lizard-electronics/Soldering_Fume_Extractor/1_Hardware/PCB/PCB_3DBack.png

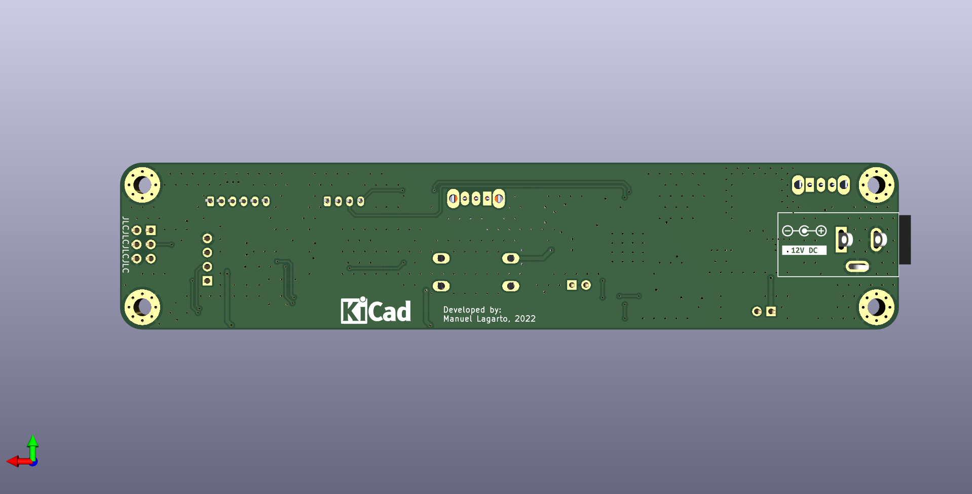
1_Hardware/PCB/PCB_3DBack.png
