lizard-electronics/Soldering_Fume_Extractor/README.md

# Soldering Fume Extractor
## [In Development...]
Portable soldering fume extractor based on an ATmega328P MCU.
