lizard-electronics/Soldering_Fume_Extractor/4_Docs/Dust Sensor Tests/dustSensor_test2.png

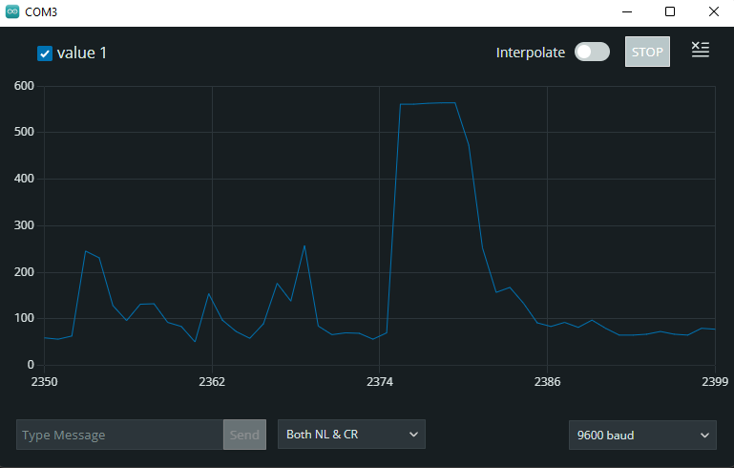
4_Docs/Dust Sensor Tests/dustSensor_test2.png
