lizard-electronics/Soldering_Fume_Extractor/4_Docs/Dust Sensor Tests/dustSensor_test.png

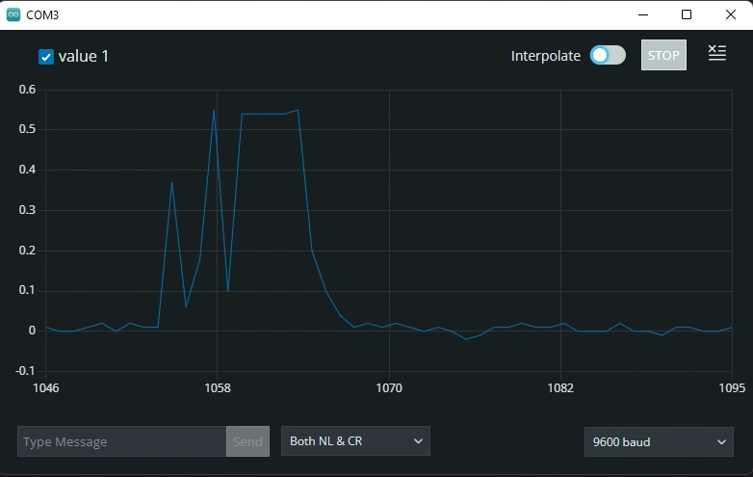
4_Docs/Dust Sensor Tests/dustSensor_test.png
