lizard-electronics/Soldering_Fume_Extractor/4_Docs/Dust Sensor Tests/SharpGP2Y1010AU0F_Graph.png

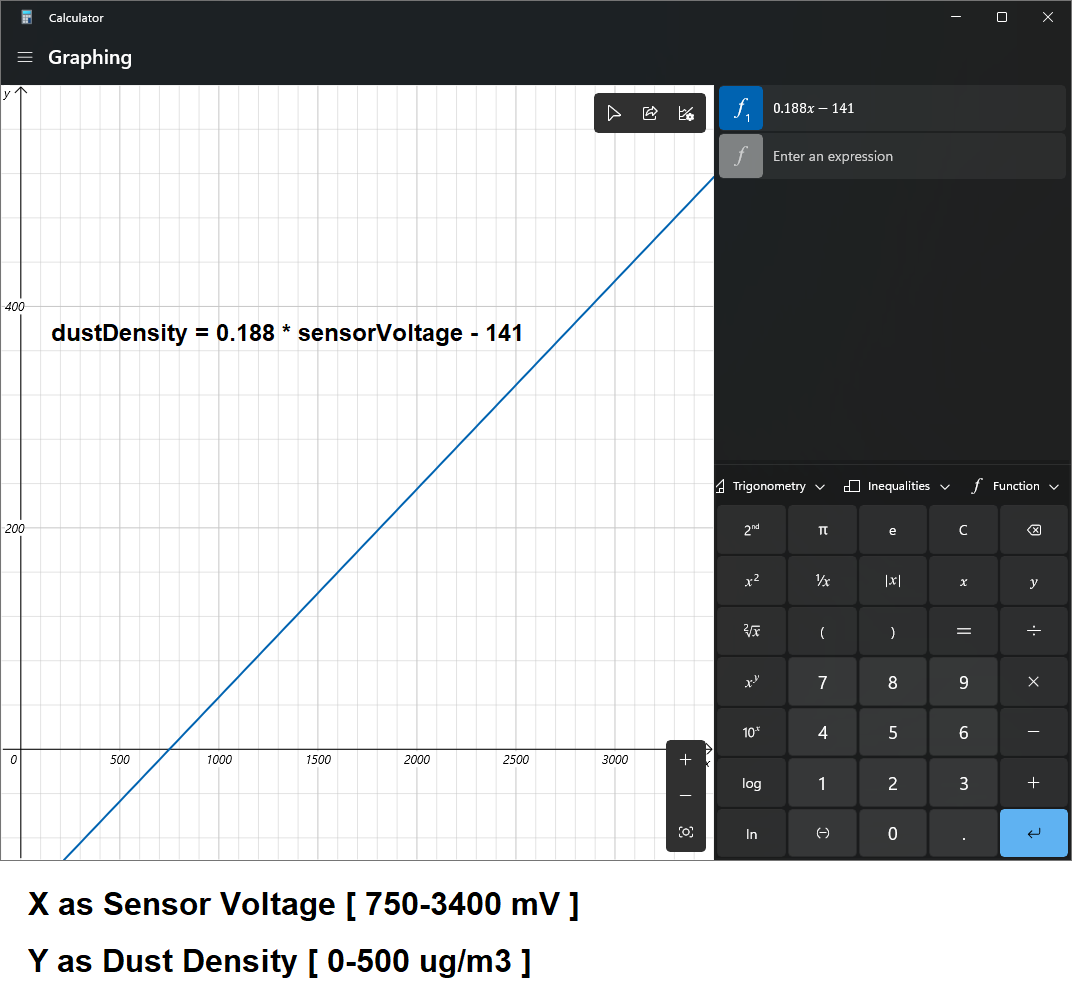
4_Docs/Dust Sensor Tests/SharpGP2Y1010AU0F_Graph.png
