lizard-electronics/Soldering_Fume_Extractor/4_Docs/FumeExtractor_Diagrams.pdf

# Power Supply Circuit Diagram

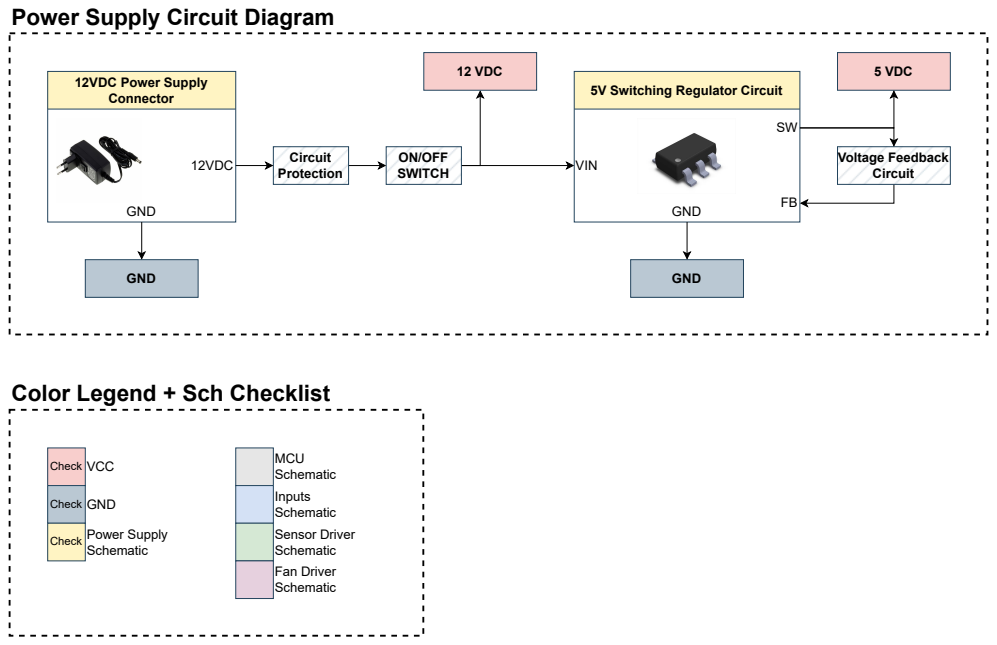
[picture p7: page 1]
Check VCC; Check GND; MCU Schematic; Inputs Schematic; Sensor Driver Schematic; Fan Driver Schematic; 12VDC Power Supply Connector; 12VDC; GND; VIN; 5 VDC; ON/OFF SWITCH; Circuit Protection; 12 VDC; Voltage Feedback Circuit

5V Switching Regulator Circuit

Color Legend + Sch Checklist

Check Power Supply
Schematic

# Fan Control Circuit Diagram

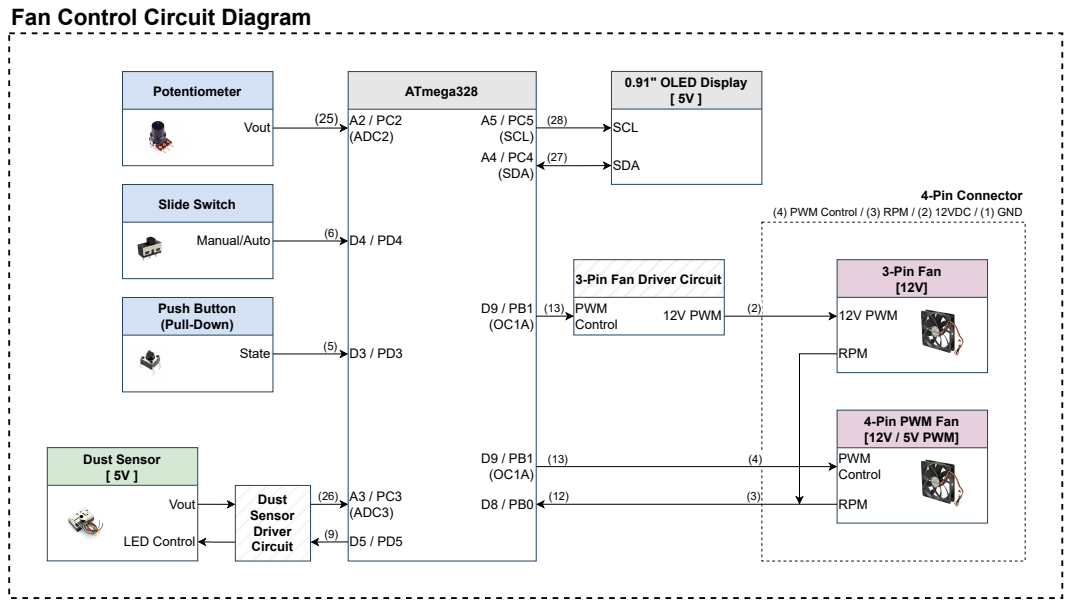
[picture p8: page 2]
ATmega328; A4 / PC4 (SDA); A5 / PC5 (SCL); A2 / PC2 (ADC2); A3 / PC3 (ADC3); 0.91" OLED Display [ 5V ]; SDA; SCL; Slide Switch; Manual/Auto; RPM; Dust Sensor [ 5V ]; Vout; LED Control; 3-Pin Fan [12V]; 12V PWM; PWM; Control; 12V PWM ⁽¹³⁾; 4-Pin Connector; Push Button (Pull-Down); State; Dust Sensor Driver Circuit; Potentiometer

(4) PWM Control / (3) RPM / (2) 12VDC / (1) GND

3-Pin Fan Driver Circuit

4-Pin PWM Fan
[12V / 5V PWM]
PWM
Control
