lizard-electronics/Soldering_Fume_Extractor/(list of files, drawings)

Other design files:
1_Hardware/PSPICE_Simulations/FumeExtractor_FanDriverTest.ms14
1_Hardware/PSPICE_Simulations/FumeExtractor_InputsTest.ms14
