lizard-electronics/Soldering_Fume_Extractor/1_Hardware/PCB/FumeExtractorBoard_v1/FumeExtractorBoard_v1.kicad_pcb

## KiCad design 1_Hardware/PCB/FumeExtractorBoard_v1/FumeExtractorBoard_v1.kicad_pcb (2022-10-18)

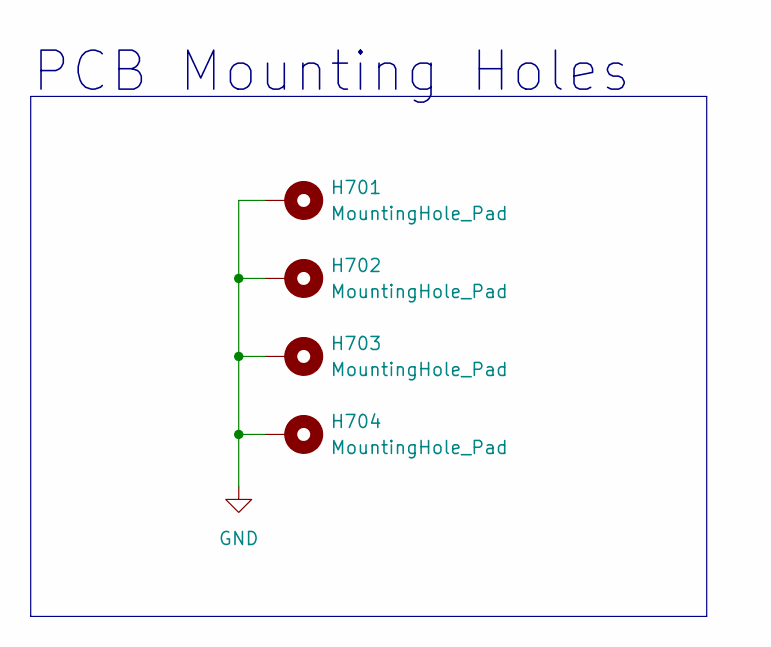
[picture p16: schematic MechanicalParts.kicad_sch, Mechanical Parts Schematic]

Parts:
H701, H702, H703, H704: MountingHole_Pad; MountingHole_3.2mm_M3_Pad_Via

Connections:
GND: H701.1, H702.1, H703.1, H704.1; also elsewhere on the board

Notes on the sheet:
PCB Mounting Holes

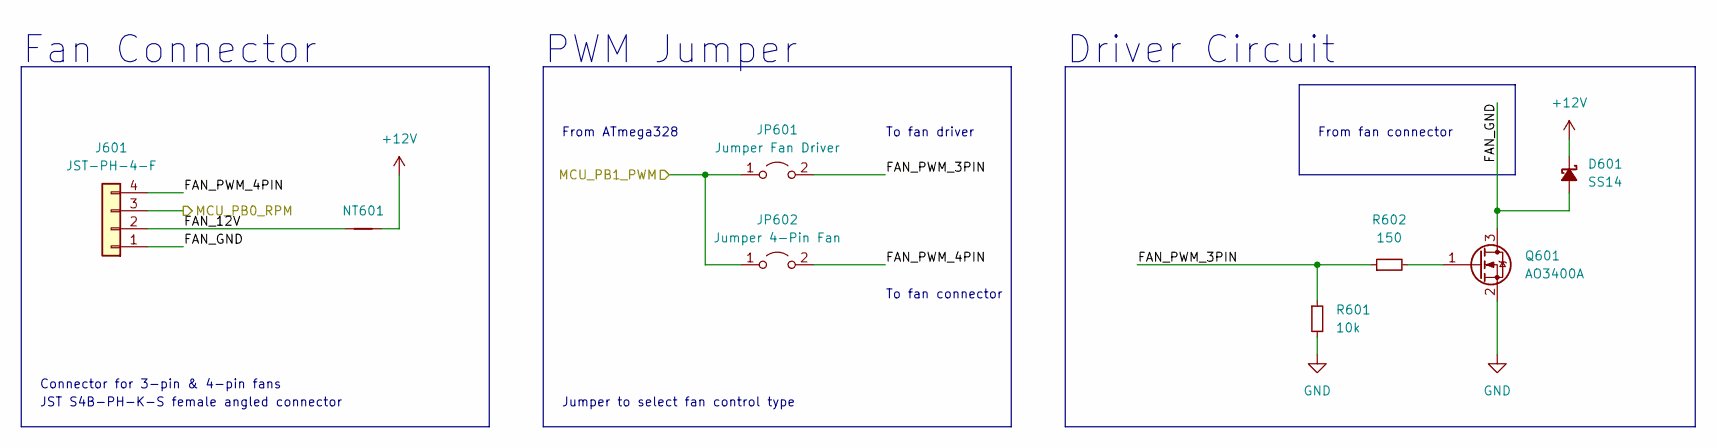
[picture p17: schematic FanDriver.kicad_sch, Fan Driver Circuit]

Parts:
D601: SS14; D_SMA
J601: JST-PH-4-F; JST_PH_S4B-PH-K_1x04_P2.00mm_Horizontal
JP601: Jumper Fan Driver; SolderJumper-2_P1.3mm_Open_RoundedPad1.0x1.5mm
JP602: Jumper 4-Pin Fan; SolderJumper-2_P1.3mm_Open_RoundedPad1.0x1.5mm
NT601: NetTie_2; NetTie-2_SMD_Pad0.5mm
Q601: AO3400A; SOT-23
R601: 10k; R_0603_1608Metric_Pad0.98x0.95mm_HandSolder
R602: 150; R_0805_2012Metric_Pad1.20x1.40mm_HandSolder

Connections:
+12V: D601.1 (K), NT601.2; also elsewhere on the board
/FanDriver/FAN_12V: J601.2, NT601.1
/FanDriver/FAN_GND: D601.2 (A), J601.1, Q601.3 (D)
/FanDriver/FAN_PWM_3PIN: JP601.2 (B), R601.1, R602.1
/FanDriver/FAN_PWM_4PIN: J601.4, JP602.2 (B)
/FanDriver/MCU_PB0_RPM: J601.3; also elsewhere on the board
/FanDriver/MCU_PB1_PWM: JP601.1 (A), JP602.1 (A); also elsewhere on the board
GND: Q601.2 (S), R601.2; also elsewhere on the board
unnamed: Q601.1 (G), R602.2

Notes on the sheet:
To fan connector
To fan driver
From fan connector
JST S4B-PH-K-S female angled connector
Fan Connector
PWM Jumper
Driver Circuit
Connector for 3-pin & 4-pin fans
From ATmega328
Jumper to select fan control type

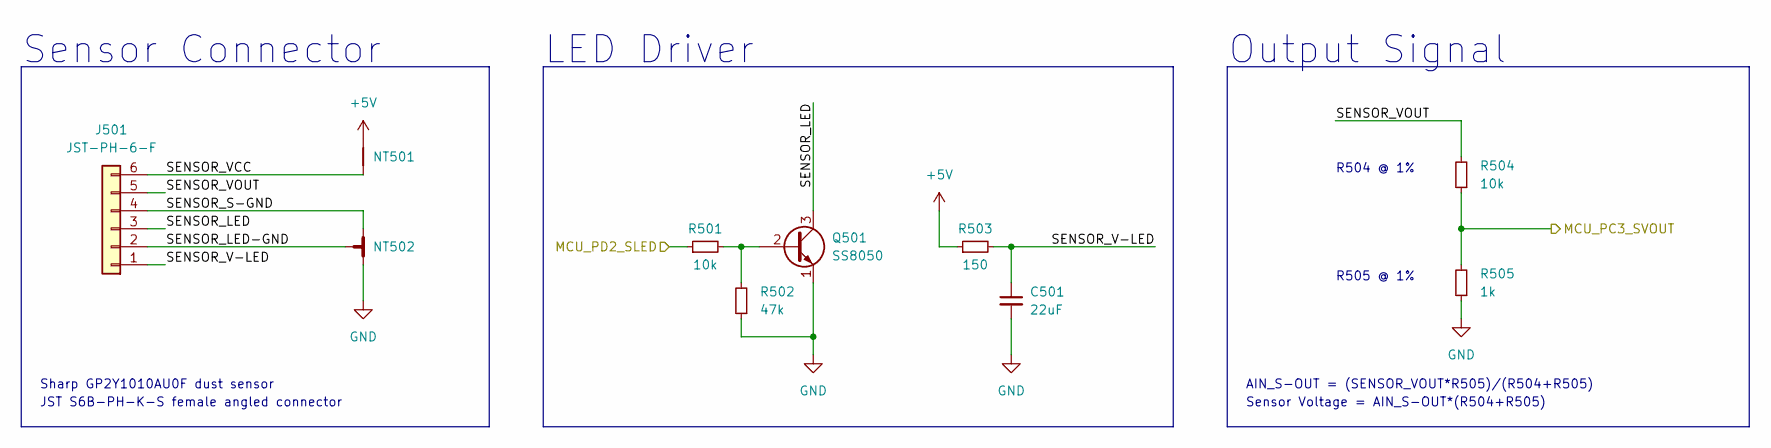
[picture p18: schematic SensorDriver.kicad_sch, Dust Sensor Driver Circuit]

Parts:
C501: 22uF; C_0805_2012Metric_Pad1.18x1.45mm_HandSolder
J501: JST-PH-6-F; JST_PH_S6B-PH-K_1x06_P2.00mm_Horizontal
NT501: NetTie_2; NetTie-2_SMD_Pad0.5mm
NT502: NetTie_3_Tee; NetTie-3_SMD_Pad0.5mm
Q501: SS8050; SOT-23
R501, R504: 10k; R_0603_1608Metric_Pad0.98x0.95mm_HandSolder
R502: 47k; R_0603_1608Metric_Pad0.98x0.95mm_HandSolder
R503: 150; R_0805_2012Metric_Pad1.20x1.40mm_HandSolder
R505: 1k; R_0603_1608Metric_Pad0.98x0.95mm_HandSolder

Connections:
+5V: NT501.2, R503.1; also elsewhere on the board
/MCU/MCU_PC3_SVOUT: R504.1, R505.2; also elsewhere on the board
/MCU/MCU_PD2_SLED: R501.1; also elsewhere on the board
/SensorDriver/SENSOR_LED: J501.3, Q501.3 (C)
/SensorDriver/SENSOR_LED-GND: J501.2, NT502.3
/SensorDriver/SENSOR_S-GND: J501.4, NT502.1
/SensorDriver/SENSOR_V-LED: C501.1, J501.1, R503.2
/SensorDriver/SENSOR_VCC: J501.6, NT501.1
/SensorDriver/SENSOR_VOUT: J501.5, R504.2
GND: C501.2, NT502.2, Q501.1 (E), R502.1, R505.1; also elsewhere on the board
unnamed: Q501.2 (B), R501.2, R502.2

Notes on the sheet:
R505 @ 1%
AIN_S-OUT = (SENSOR_VOUT*R505)/(R504+R505)
Sharp GP2Y1010AU0F dust sensor
Sensor Connector
Output Signal
Sensor Voltage = AIN_S-OUT*(R504+R505)
LED Driver
R504 @ 1%
JST S6B-PH-K-S female angled connector

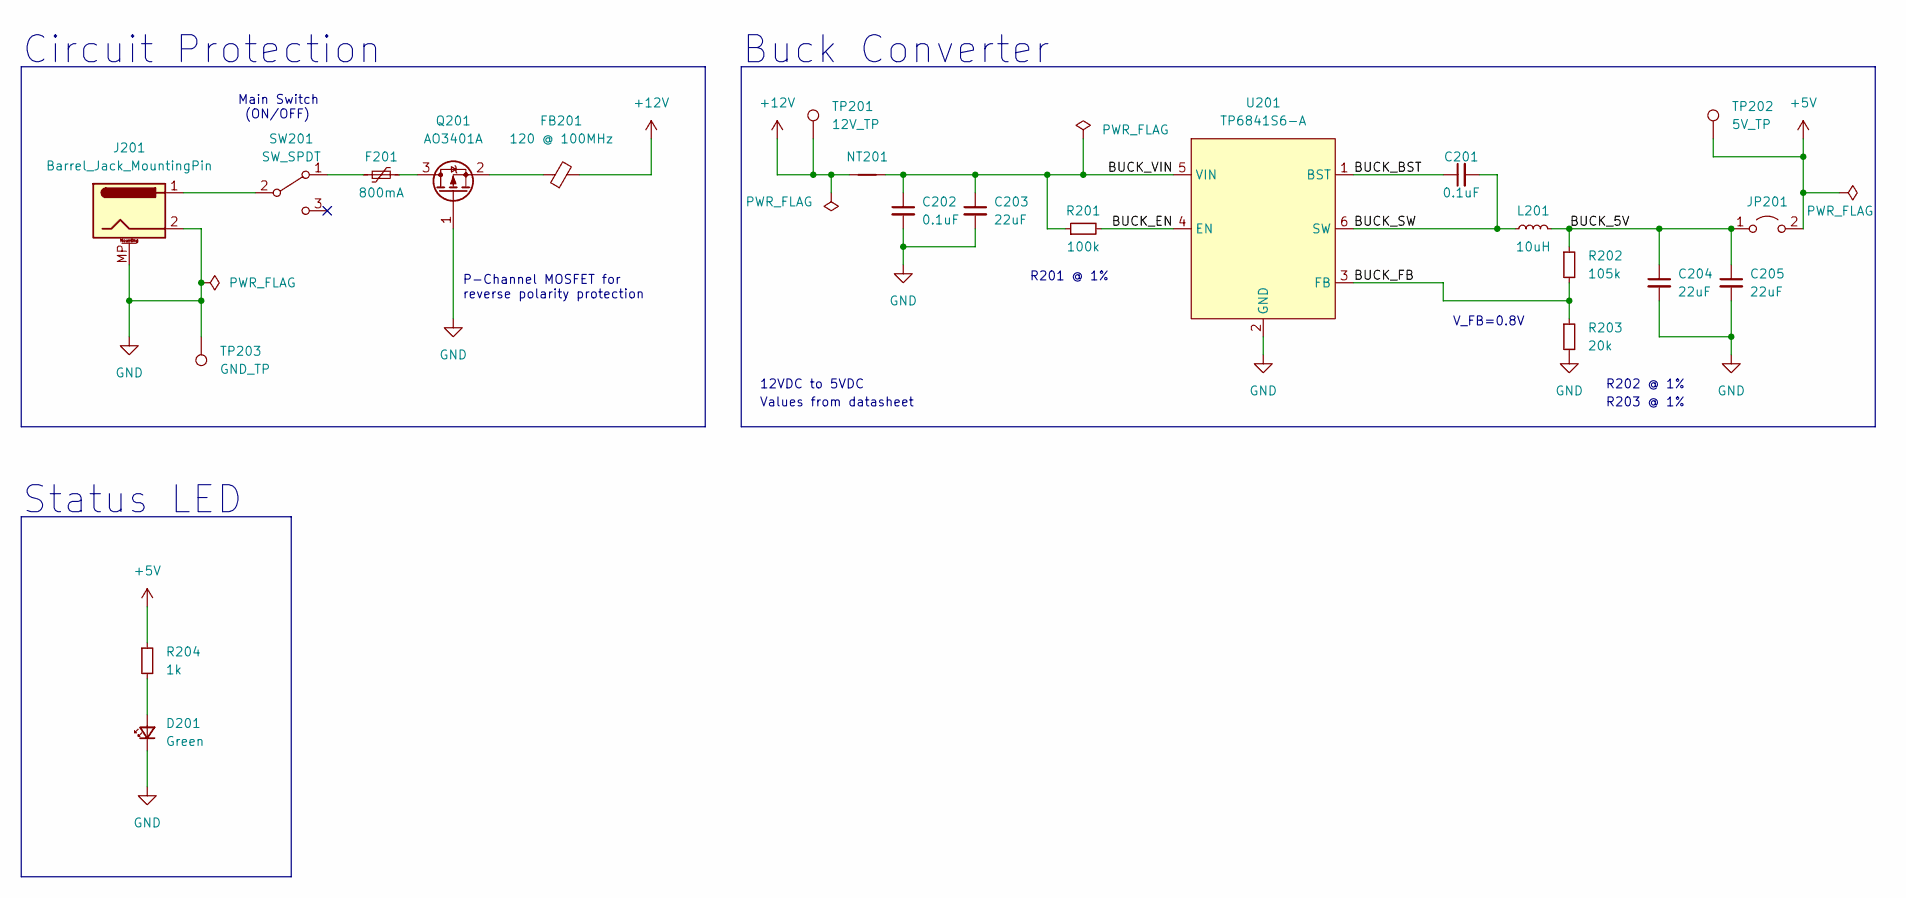
[picture p19: schematic PowerSupply.kicad_sch, Power Supply Circuit]

Parts:
C201: 0.1uF; C_0603_1608Metric_Pad1.08x0.95mm_HandSolder
C202: 0.1uF; C_0805_2012Metric_Pad1.18x1.45mm_HandSolder
C203, C204, C205: 22uF; C_0805_2012Metric_Pad1.18x1.45mm_HandSolder
D201: Green; LED_0805_2012Metric_Pad1.15x1.40mm_HandSolder
F201: 800mA; Fuse_1812_4532Metric
FB201: 120 @ 100MHz; L_0805_2012Metric_Pad1.05x1.20mm_HandSolder
J201: Barrel_Jack_MountingPin; BarrelJack_GCT_DCJ200-10-A_Horizontal
JP201: Jumper 5V; PinHeader_1x02_P2.54mm_Vertical
L201: 10uH; L_Sunlord_MWSA0518_5.4x5.2mm
NT201: NetTie_2; NetTie-2_SMD_Pad0.5mm
Q201: AO3401A; SOT-23
R201: 100k; R_0805_2012Metric_Pad1.20x1.40mm_HandSolder
R202: 105k; R_0805_2012Metric_Pad1.20x1.40mm_HandSolder
R203: 20k; R_0805_2012Metric_Pad1.20x1.40mm_HandSolder
R204: 1k; R_0805_2012Metric_Pad1.20x1.40mm_HandSolder
SW201: SW_SPDT; SW_Slide_1P2T_CK_OS102011MS2Q
TP201: 12V_TP; TestPoint_Pad_D1.5mm
TP202: 5V_TP; TestPoint_Pad_D1.5mm
TP203: GND_TP; TestPoint_Pad_D1.5mm
U201: TP6841S6-A; SOT-23-6

Connections:
+5V: JP201.2 (B), R204.1, TP202.1; also elsewhere on the board
+12V: FB201.2, NT201.1, TP201.1; also elsewhere on the board
/PowerSupply/BUCK_5V: C204.1, C205.1, JP201.1 (A), L201.2, R202.1
/PowerSupply/BUCK_BST: C201.1, U201.1 (BST)
/PowerSupply/BUCK_EN: R201.2, U201.4 (EN)
/PowerSupply/BUCK_FB: R202.2, R203.1, U201.3 (FB)
/PowerSupply/BUCK_SW: C201.2, L201.1, U201.6 (SW)
/PowerSupply/BUCK_VIN: C202.1, C203.1, NT201.2, R201.1, U201.5 (VIN)
GND: C202.2, C203.2, C204.2, C205.2, D201.1 (K), J201.2, J201.3, J201.MP (MountPin), Q201.1 (G), R203.2, TP203.1, U201.2 (GND); also elsewhere on the board
unnamed: D201.2 (A), R204.2
unnamed: F201.1, SW201.1 (A)
unnamed: F201.2, Q201.3 (D)
unnamed: FB201.1, Q201.2 (S)
unnamed: J201.1, SW201.2 (B)

Notes on the sheet:
R201 @ 1%
Circuit Protection
Buck Converter
Status LED
12VDC to 5VDC
R202 @ 1%
V_FB=0.8V
R203 @ 1%
Values from datasheet
P-Channel MOSFET for reverse polarity protection
Main Switch (ON/OFF)

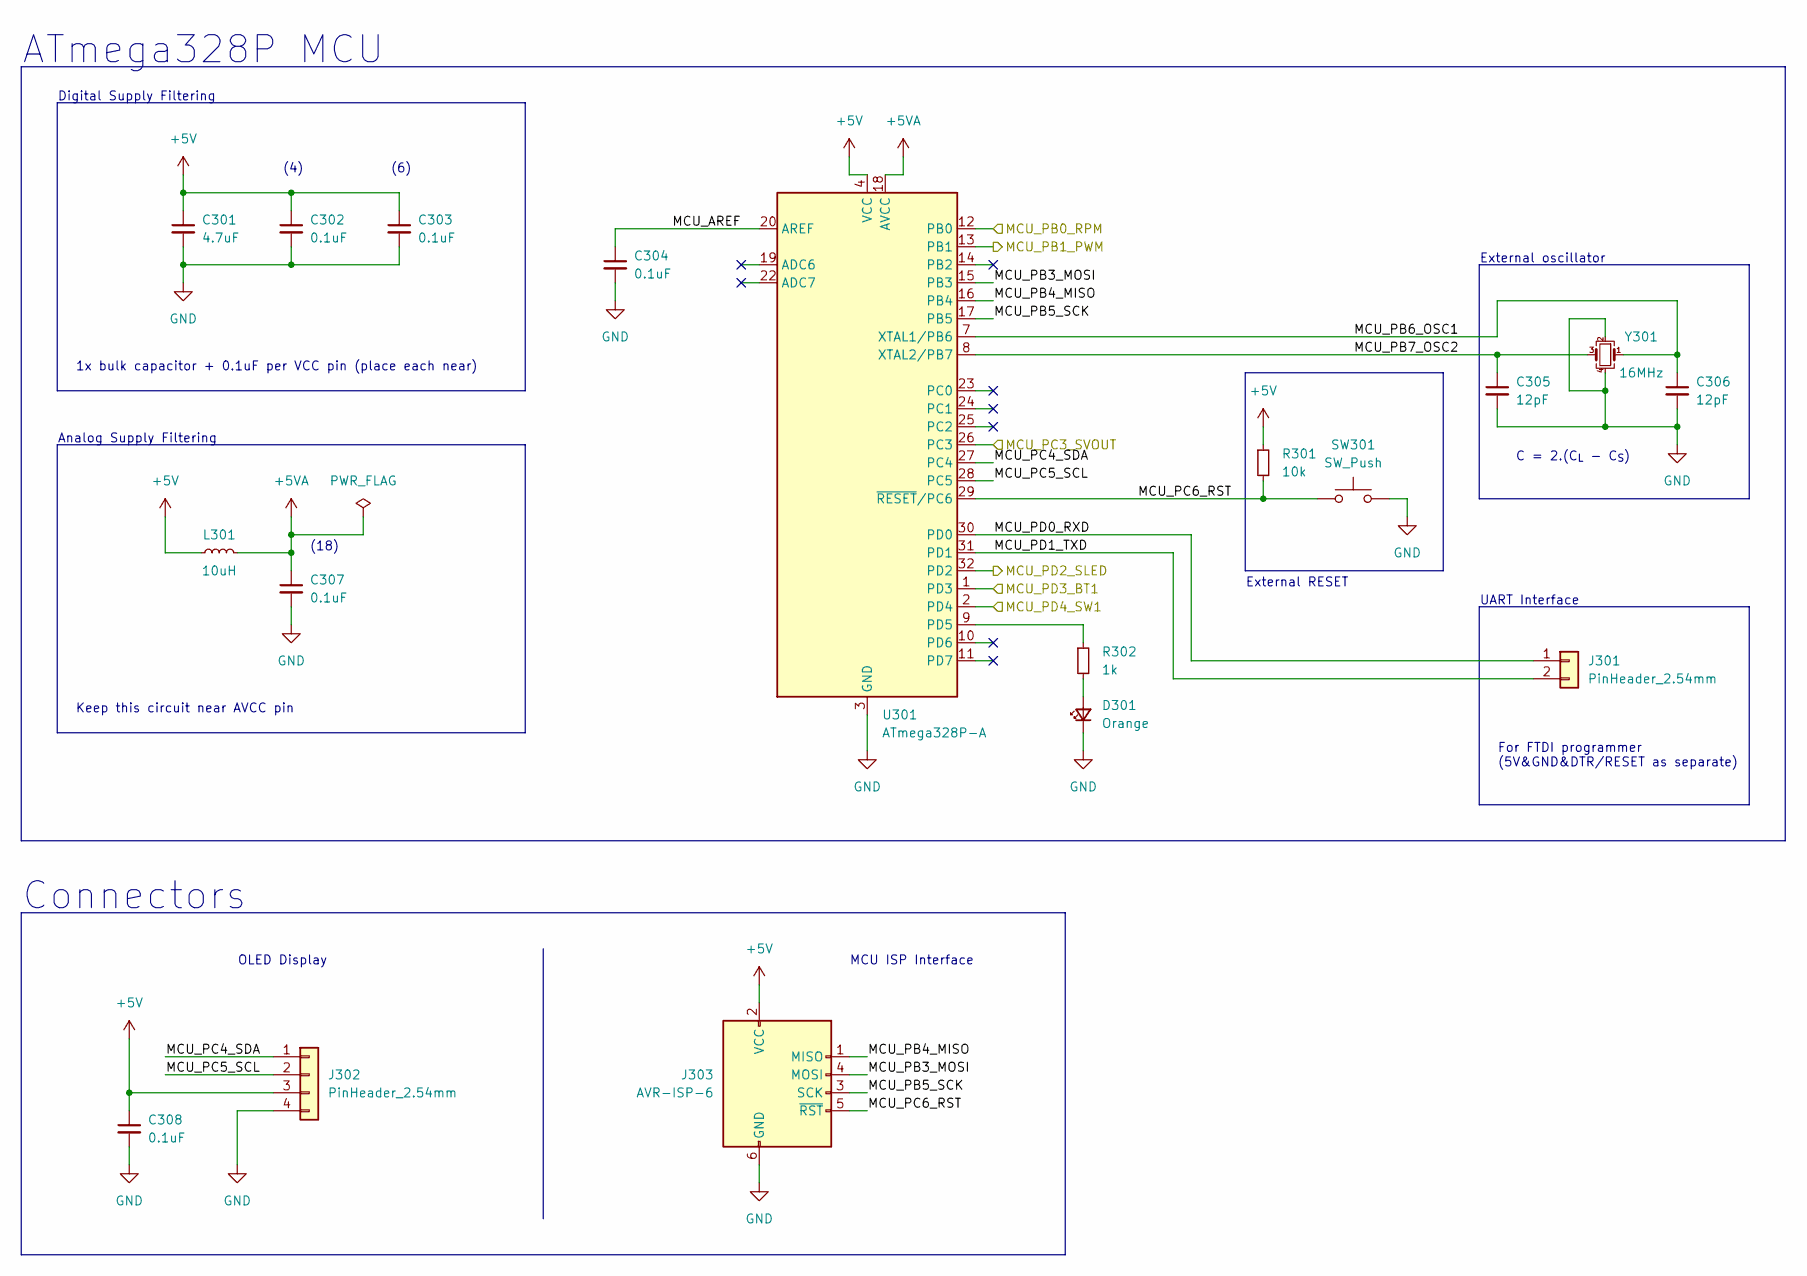
[picture p20: schematic MCU.kicad_sch, MCU Circuit & Board Interfaces]

Parts:
C301: 4.7uF; C_0805_2012Metric_Pad1.18x1.45mm_HandSolder
C302, C303, C304, C307, C308: 0.1uF; C_0603_1608Metric_Pad1.08x0.95mm_HandSolder
C305, C306: 12pF; C_0603_1608Metric_Pad1.08x0.95mm_HandSolder
D301: Orange; LED_0805_2012Metric_Pad1.15x1.40mm_HandSolder
J301: PinHeader_2.54mm; PinHeader_1x02_P2.54mm_Vertical
J302: PinHeader_2.54mm; PinSocket_1x04_P2.54mm_Vertical
J303: AVR-ISP-6; PinHeader_2x03_P2.54mm_Vertical
L301: 10uH; L_0805_2012Metric_Pad1.05x1.20mm_HandSolder
R301: 10k; R_0603_1608Metric_Pad0.98x0.95mm_HandSolder
R302: 1k; R_0805_2012Metric_Pad1.20x1.40mm_HandSolder
SW301: SW_Push; SW_SPST_TL3342
U301: ATmega328P-A; TQFP-32_7x7mm_P0.8mm
Y301: 16MHz; Crystal_SMD_3225-4Pin_3.2x2.5mm_HandSoldering

Connections:
+5V: C301.1, C302.1, C303.1, C308.1, J302.3, J303.2 (VCC), L301.1, R301.1, U301.4 (VCC), U301.6 (VCC); also elsewhere on the board
+5VA: C307.1, L301.2, U301.18 (AVCC)
/FanDriver/MCU_PB0_RPM: U301.12 (PB0); also elsewhere on the board
/FanDriver/MCU_PB1_PWM: U301.13 (PB1); also elsewhere on the board
/Inputs/MCU_PD3_BT1: U301.1 (PD3); also elsewhere on the board
/Inputs/MCU_PD4_SW1: U301.2 (PD4); also elsewhere on the board
/MCU/MCU_AREF: C304.1, U301.20 (AREF)
/MCU/MCU_PB3_MOSI: J303.4 (MOSI), U301.15 (PB3)
/MCU/MCU_PB4_MISO: J303.1 (MISO), U301.16 (PB4)
/MCU/MCU_PB5_SCK: J303.3 (SCK), U301.17 (PB5)
/MCU/MCU_PB6_OSC1: C306.1, U301.7 (XTAL1/PB6), Y301.1
/MCU/MCU_PB7_OSC2: C305.1, U301.8 (XTAL2/PB7), Y301.3
/MCU/MCU_PC3_SVOUT: U301.26 (PC3); also elsewhere on the board
/MCU/MCU_PC4_SDA: J302.1, U301.27 (PC4)
/MCU/MCU_PC5_SCL: J302.2, U301.28 (PC5)
/MCU/MCU_PC6_RST: J303.5 (~RST), R301.2, SW301.1, U301.29 (~RESET/PC6)
/MCU/MCU_PD0_RXD: J301.1, U301.30 (PD0)
/MCU/MCU_PD1_TXD: J301.2, U301.31 (PD1)
/MCU/MCU_PD2_SLED: U301.32 (PD2); also elsewhere on the board
GND: C301.2, C302.2, C303.2, C304.2, C305.2, C306.2, C307.2, C308.2, D301.1 (K), J302.4, J303.6 (GND), SW301.2, U301.3 (GND), U301.5 (GND), U301.21 (GND), Y301.2, Y301.4; also elsewhere on the board
unnamed: D301.2 (A), R302.2
unnamed: R302.1, U301.9 (PD5)

Notes on the sheet:
ATmega328P MCU
(4)
MCU ISP Interface
UART Interface
(18)
(6)
1x bulk capacitor + 0.1uF per VCC pin (place each near)
External RESET
Connectors
External oscillator
OLED Display
Digital Supply Filtering
C = 2.(C_{L} - C_{S})
Keep this circuit near AVCC pin
Analog Supply Filtering
For FTDI programmer (5V&GND&DTR/RESET as separate)

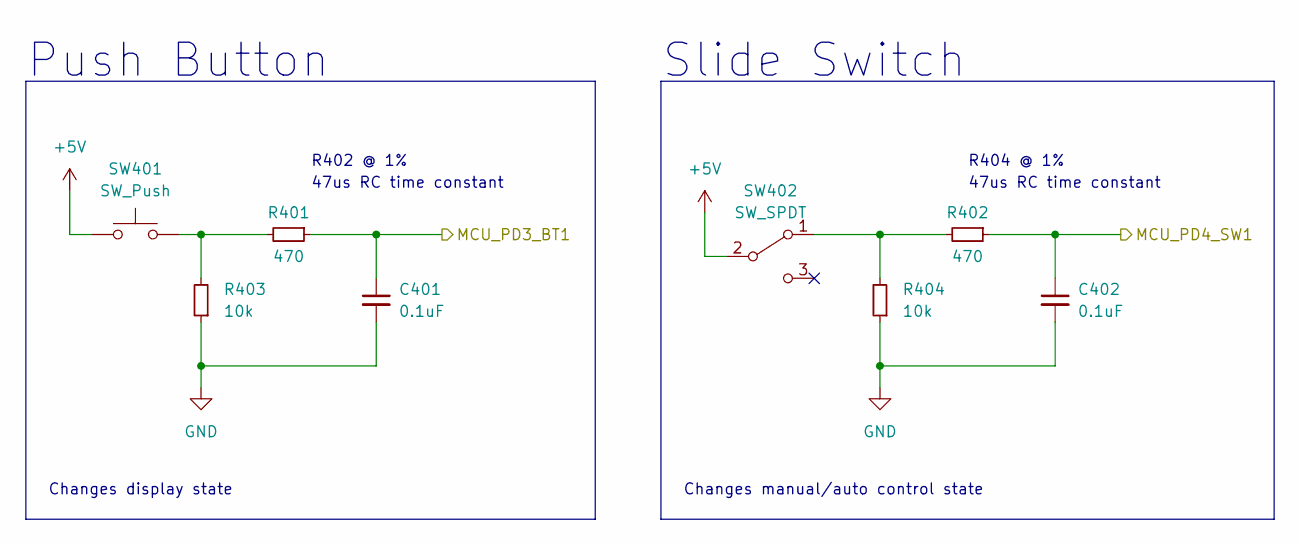
[picture p21: schematic Inputs.kicad_sch, Input Signal Circuits]

Parts:
C401, C402: 0.1uF; C_0603_1608Metric_Pad1.08x0.95mm_HandSolder
R401, R402: 470; R_0603_1608Metric_Pad0.98x0.95mm_HandSolder
R403, R404: 10k; R_0603_1608Metric_Pad0.98x0.95mm_HandSolder
SW401: SW_Push; SW_PUSH-12mm
SW402: SW_SPDT; SW_Slide_1P2T_CK_OS102011MS2Q

Connections:
+5V: SW401.1, SW402.2 (B); also elsewhere on the board
/Inputs/MCU_PD3_BT1: C401.1, R401.1; also elsewhere on the board
/Inputs/MCU_PD4_SW1: C402.1, R402.1; also elsewhere on the board
GND: C401.2, C402.2, R403.1, R404.1; also elsewhere on the board
unnamed: R401.2, R403.2, SW401.2
unnamed: R402.2, R404.2, SW402.1 (A)

Notes on the sheet:
R404 @ 1%
Slide Switch
Push Button
Changes display state
R402 @ 1%
Changes manual/auto control state
47us RC time constant

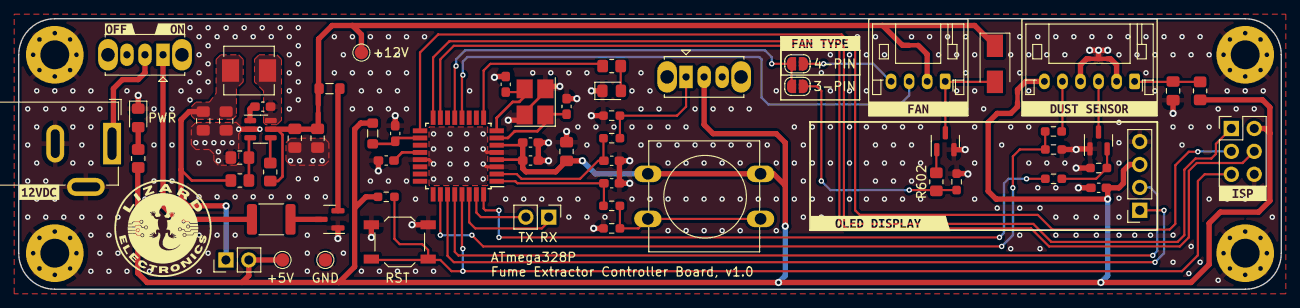
[picture p22: board FumeExtractorBoard_v1.kicad_pcb from above]

Board: 2 copper layers, 140.0 x 30.0 mm, 79 parts (1 on the bottom side), 48 nets.

Other parts of the board:
kibuzzard-6334A8D3: G***; kibuzzard-6334A8D3
kibuzzard-63330C57: G***; kibuzzard-63330C57
kibuzzard-63330D54: G***; kibuzzard-63330D54
kibuzzard-63330DD6: G***; kibuzzard-63330DD6
kibuzzard-63330FE0: G***; kibuzzard-63330FE0
kibuzzard-633311A9: G***; kibuzzard-633311A9
kibuzzard-6333156D: G***; kibuzzard-6333156D
kibuzzard-63331390: G***; kibuzzard-63331390
kibuzzard-63331553: G***; kibuzzard-63331553
