lizard-electronics/Soldering_Fume_Extractor/(commit log)

2023-02-27 File Organization
    1. Synchronization with GitHub repository.
    2. Added software files from developed test programs.
    [FumeExtractor_FanDriverTest.ms14, FumeExtractor_InputsTest.ms14]
2023-02-27 File Organization
    [LCSC_Exported_20221002_070828.xlsx]
